szcz761/BD2/README.md

# BD2
Robot klasy minisumo tworzony przez: Szymona Czaje.
Na podstawie robota: Biała-Dama współtworzonego z Markiem Żyśko.
