szcz761/BD2/Biała-Dama Sprawozdanie/tytulowa.tex

\renewcommand{\maketitle}{\begin{titlepage}

\begin{center}
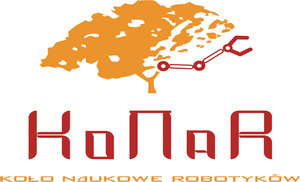
[picture p7: Biała-Dama Sprawozdanie/logo.png]

\vspace*{1cm}
\noindent \rule{\linewidth}{0.4mm}
\LARGE \textsc{Raport z Budowy Robota: \\ BD2} % Tutaj należy umieścić tytuł projektu 
\vspace*{0.5cm}
\rule{\linewidth}{0.4mm}
\vspace*{1cm}
\LARGE
\textsc{Wykonał: Szymon Czaja}  \\% W tym miejscu należy zamieścić 
\textsc{} \\
\large
\textsc{Na bazie projektu Biała Dama stworzonego przez Szymona Czaje i Marka Żyśko } \\ % W tym miejscu należy zamieścić 

\vspace*{2cm}
\textsc{Koło Naukowe Robotyków KoNaR }\\
\textsc{\url{www.konar.pwr.edu.pl}}\\
\textsc{\today}\\
\end{center}
\end{titlepage}
\newpage
}
