szcz761/BD2/Biała-Dama Sprawozdanie/figures/ledy.png

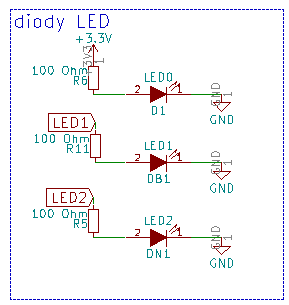
Biała-Dama Sprawozdanie/figures/ledy.png
