szcz761/BD2/Biała-Dama Sprawozdanie/figures/stabilizacja.png

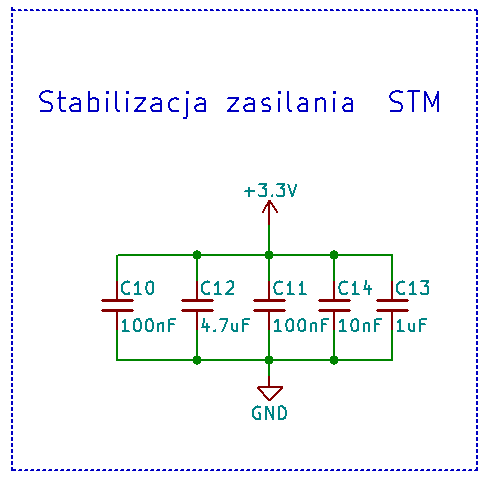
Biała-Dama Sprawozdanie/figures/stabilizacja.png
