szcz761/BD2/(list of files, cad)

Other CAD files:
BDinv.iam
