szcz761/BD2/BD2 - Projekt płytki/BD.kicad_pcb

## KiCad design BD2 - Projekt płytki/BD.kicad_pcb (2018-01-29)

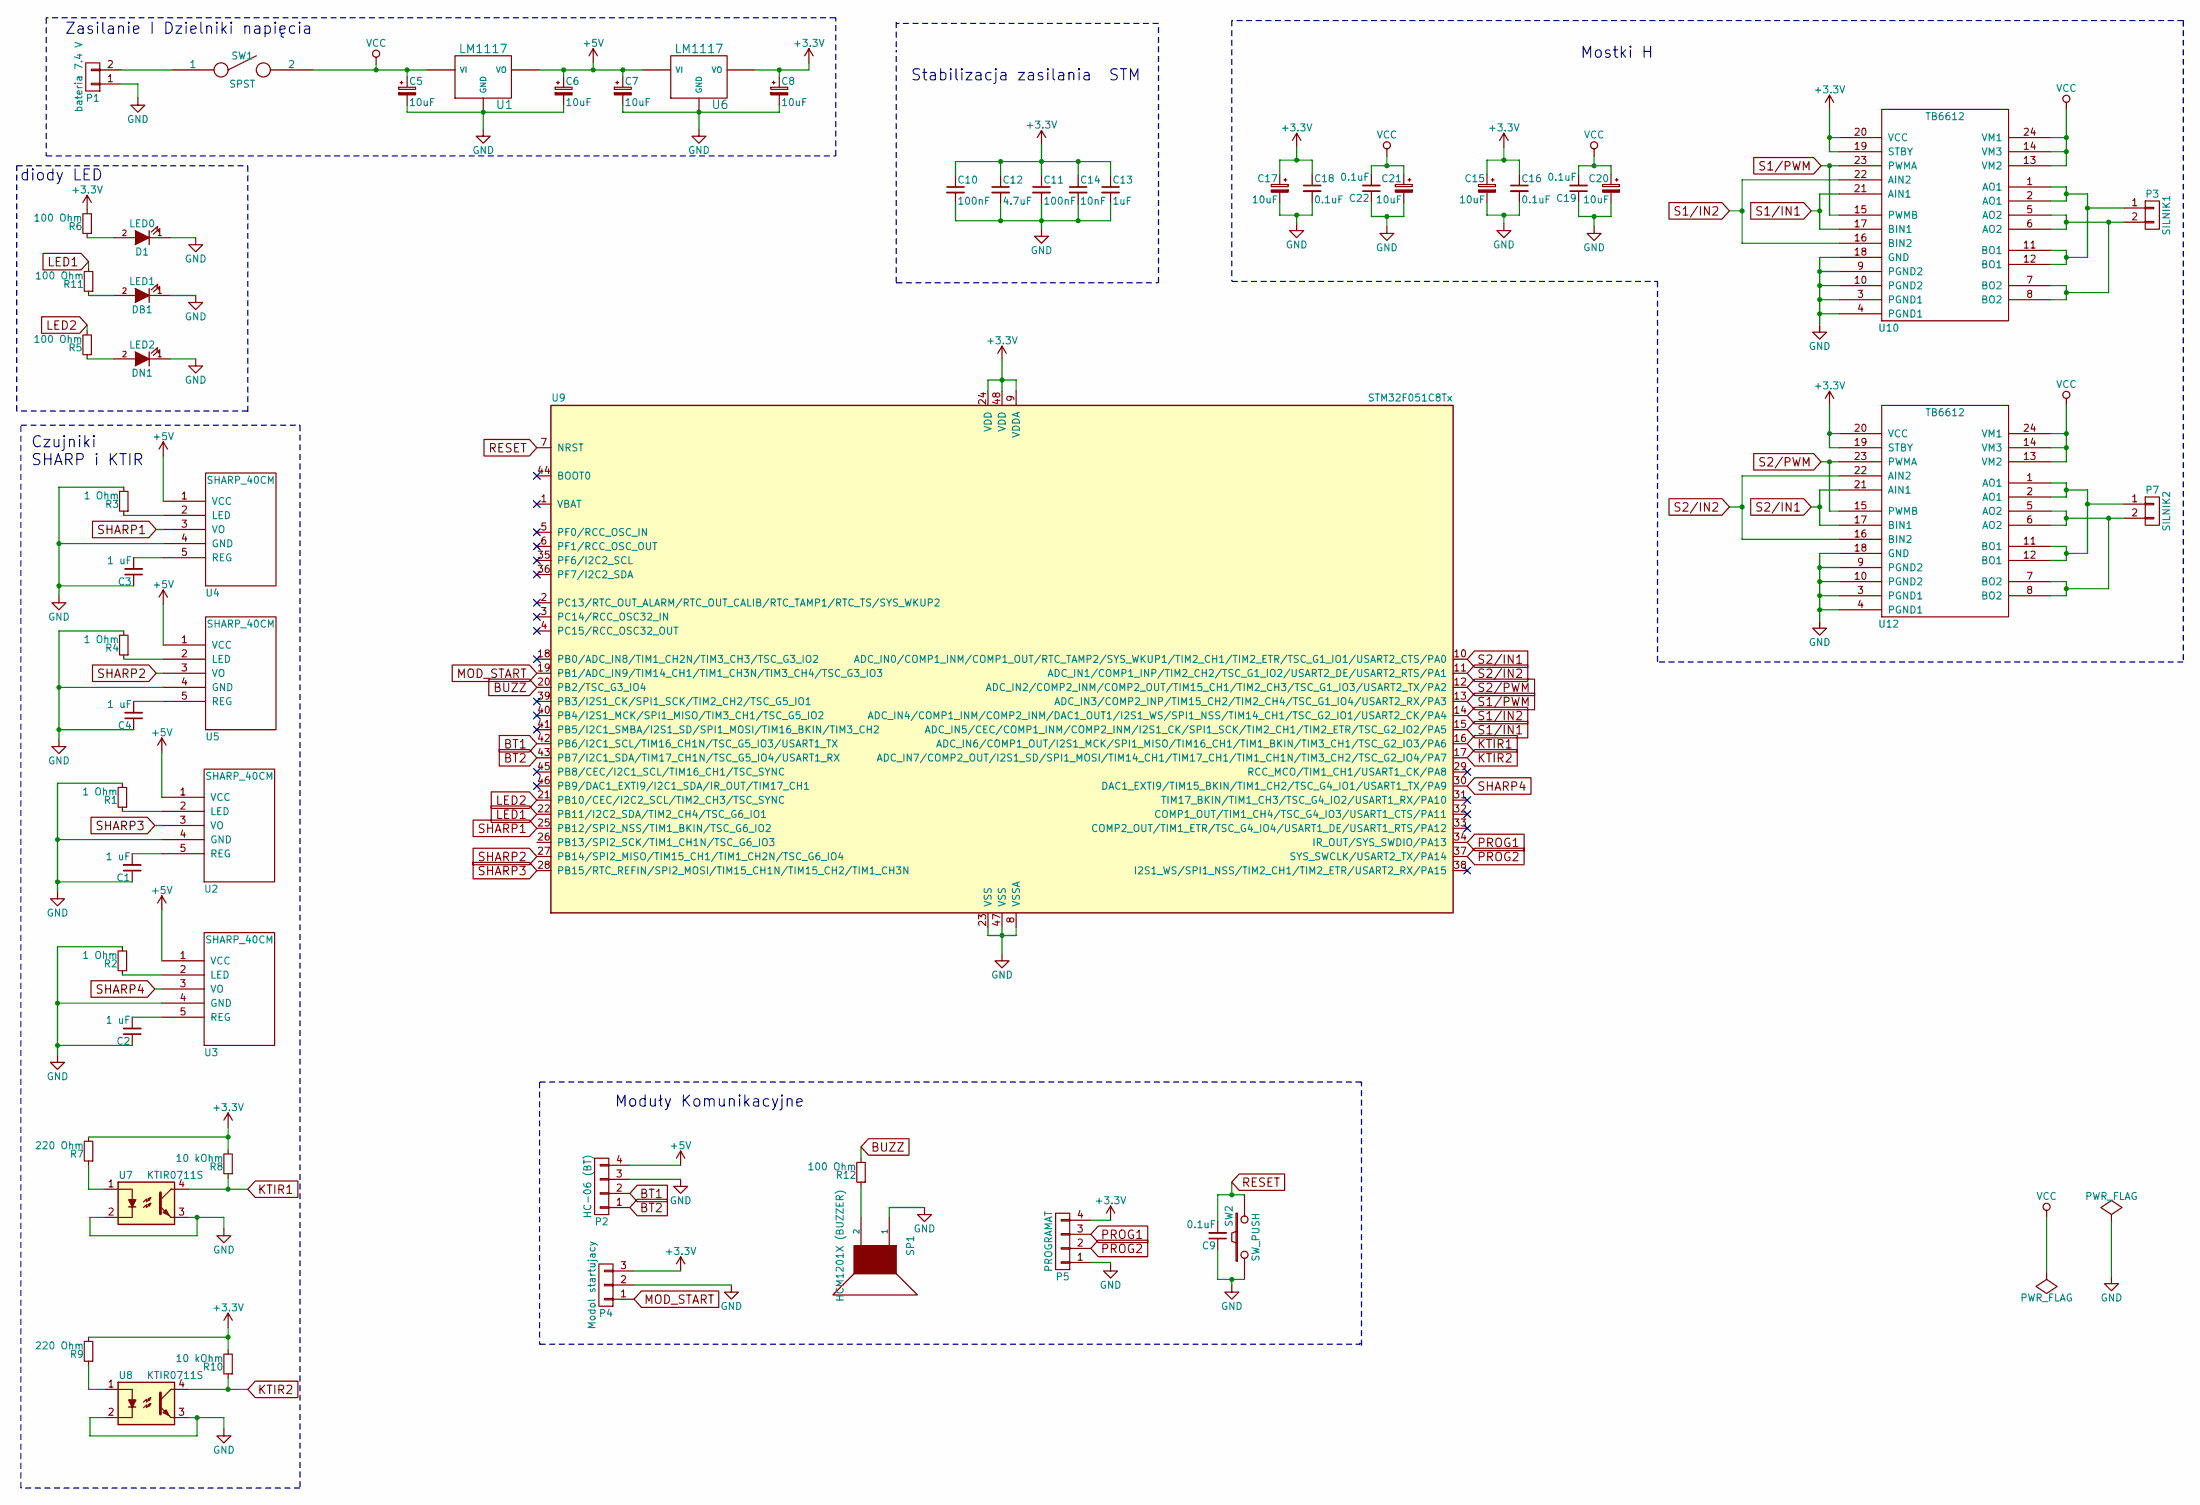
[picture p10: schematic BD.sch]

Parts:
C1, C2, C3, C4: 1 uF; C_0805_HandSoldering
C5, C6, C7, C8, C15, C17, C20, C21: 10uF; Tantalum_Case-A_EIA-3216-18_Hand
C9, C16, C18, C19, C22: 0.1uF; C_0805_HandSoldering
C10, C11: 100nF; C_0805_HandSoldering
C12: 4.7uF; C_0805_HandSoldering
C13: 1uF; C_0805_HandSoldering
C14: 10nF; C_0805_HandSoldering
D1: LED0; LED_0805
DB1: LED1; LED_0805
DN1: LED2; LED_0805
P1: bateria 7.4 V; Socket_Strip_Straight_1x02
P2: HC-06 (BT); Socket_Strip_Straight_1x04
P3: SILNIK1; Socket_Strip_Straight_1x02
P4: Modol startujacy; Socket_Strip_Straight_1x03
P5: PROGRAMAT; Socket_Strip_Straight_1x04
P7: SILNIK2; Socket_Strip_Straight_1x02
R1, R2, R3, R4: 1 Ohm; R_0805_HandSoldering
R5, R6, R11, R12: 100 Ohm; R_0805_HandSoldering
R7, R9: 220 Ohm; R_0805_HandSoldering
R8, R10: 10 kOhm; R_0805_HandSoldering
SP1: HCM1201X (BUZZER); Buzzer_12x9.5RM7.6
SW1: SPST; SW_DIP_x1_Slide
SW2: SW_PUSH; SW_PUSH_6mm
U1, U6: LM1117; LM1117_SOT223
U2, U3, U4, U5: SHARP_40CM; GP2Y0D340K
U7, U8: KTIR0711S
U9: STM32F051C8Tx; STM32F051C8T6
U10, U12: TB6612

Connections:
+3V3: C8.1, C10.1, C11.1, C12.1, C13.1, C14.1, C15.1, C16.1, C17.1, C18.1, P4.3, P5.4, R6.2, R7.2, R8.2, R9.2, R10.2, U6.2 (VO), U9.9 (VDDA), U9.24 (VDD), U9.48 (VDD), U10.19 (STBY), U10.20 (VCC), U12.19 (STBY), U12.20 (VCC)
+5V: C6.1, C7.1, P2.4, U1.2 (VO), U2.1 (VCC), U3.1 (VCC), U4.1 (VCC), U5.1 (VCC), U6.1 (VI)
BT1: P2.2, U9.42 (PB6/I2C1_SCL/TIM16_CH1N/TSC_G5_IO3/USAR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)
BT2: P2.1, U9.43 (PB7/I2C1_SDA/TIM17_CH1N/TSC_G5_IO4/USAR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)
BUZZ: R12.2, U9.20 (PB2/TSC_G3_IO4)
GND: C1.1, C2.1, C3.1, C4.1, C5.2, C6.2, C7.2, C8.2, C9.1, C10.2, C11.2, C12.2, C13.2, C14.2, C15.2, C16.2, C17.2, C18.2, C19.1, C20.2, C21.2, C22.1, D1.1 (K), DB1.1 (K), DN1.1 (K), P1.1, P2.3, P4.2, P5.1, R1.2, R2.2, R3.2, R4.2, SP1.1, SW2.1, U1.3 (GND), U2.4 (GND), U3.4 (GND), U4.4 (GND), U5.4 (GND), U6.3 (GND), U7.2, U7.3, U8.2, U8.3, U9.8 (VSSA), U9.23 (VSS), U9.47 (VSS), U10.3 (PGND1), U10.4 (PGND1), U10.9 (PGND2), U10.10 (PGND2), U10.18 (GND), U12.3 (PGND1), U12.4 (PGND1), U12.9 (PGND2), U12.10 (PGND2), U12.18 (GND)
KTIR1: R8.1, U7.4, U9.16 (ADC_IN6/COMP1_OUT/I2S1_MCK/SPI1_MISO/TI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)
KTIR2: R10.1, U8.4, U9.17 (ADC_IN7/COMP2_OUT/I2S1_SD/SPI1_MOSI/TIM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)
LED1: R11.2, U9.22 (PB11/I2C2_SDA/TIM2_CH4/TSC_G6_IO1)
LED2: R5.2, U9.21 (PB10/CEC/I2C2_SCL/TIM2_CH3/TSC_SYNC)
MOD_START: P4.1, U9.19 (PB1/ADC_IN9/TIM14_CH1/TIM1_CH3N/TIM3_CH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)
unnamed: C1.2, U2.5 (REG)
unnamed: C2.2, U3.5 (REG)
unnamed: C3.2, U4.5 (REG)
unnamed: C4.2, U5.5 (REG)
unnamed: D1.2 (A), R6.1
unnamed: DB1.2 (A), R11.1
unnamed: DN1.2 (A), R5.1
unnamed: P1.2, SW1.1
unnamed: P3.1, U10.1 (AO1), U10.2 (AO1), U10.11 (BO1), U10.12 (BO1)
unnamed: P3.2, U10.5 (AO2), U10.6 (AO2), U10.7 (BO2), U10.8 (BO2)
unnamed: P7.1, U12.1 (AO1), U12.2 (AO1), U12.11 (BO1), U12.12 (BO1)
unnamed: P7.2, U12.5 (AO2), U12.6 (AO2), U12.7 (BO2), U12.8 (BO2)
unnamed: R1.1, U2.2 (LED)
unnamed: R2.1, U3.2 (LED)
unnamed: R3.1, U4.2 (LED)
unnamed: R4.1, U5.2 (LED)
unnamed: R7.1, U7.1
unnamed: R9.1, U8.1
unnamed: R12.1, SP1.2
PROG1: P5.3, U9.34 (IR_OUT/SYS_SWDIO/PA13)
PROG2: P5.2, U9.37 (SYS_SWCLK/USART2_TX/PA14)
RESET: C9.2, SW2.2, U9.7 (NRST)
S1/IN1: U9.15 (ADC_IN5/CEC/COMP1_INM/COMP2_INM/I2S1_CK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), U10.17 (BIN1), U10.21 (AIN1)
S1/IN2: U9.14 (ADC_IN4/COMP1_INM/COMP2_INM/DAC1_OUT1/I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), U10.16 (BIN2), U10.22 (AIN2)
S1/PWM: U9.13 (ADC_IN3/COMP2_INP/TIM15_CH2/TIM2_CH4/TS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), U10.15 (PWMB), U10.23 (PWMA)
S2/IN1: U9.10 (ADC_IN0/COMP1_INM/COMP1_OUT/RTC_TAMP2/S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), U12.17 (BIN1), U12.21 (AIN1)
S2/IN2: U9.11 (ADC_IN1/COMP1_INP/TIM2_CH2/TSC_G1_IO2/U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), U12.16 (BIN2), U12.22 (AIN2)
S2/PWM: U9.12 (ADC_IN2/COMP2_INM/COMP2_OUT/TIM15_CH1/T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), U12.15 (PWMB), U12.23 (PWMA)
SHARP1: U4.3 (VO), U9.25 (PB12/SPI2_NSS/TIM1_BKIN/TSC_G6_IO2)
SHARP2: U5.3 (VO), U9.27 (PB14/SPI2_MISO/TIM15_CH1/TIM1_CH2N/TSC_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)
SHARP3: U2.3 (VO), U9.28 (PB15/RTC_REFIN/SPI2_MOSI/TIM15_CH1N/TIM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)
SHARP4: U3.3 (VO), U9.30 (DAC1_EXTI9/TIM15_BKIN/TIM1_CH2/TSC_G4_I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)
VCC: C5.1, C19.2, C20.1, C21.1, C22.2, SW1.2, U1.1 (VI), U10.13 (VM2), U10.14 (VM3), U10.24 (VM1), U12.13 (VM2), U12.14 (VM3), U12.24 (VM1)

Notes on the sheet:
Zasilanie I Dzielniki napięcia
diody LED
Czujniki SHARP i KTIR
Moduły Komunikacyjne
Mostki H
Stabilizacja zasilania STM

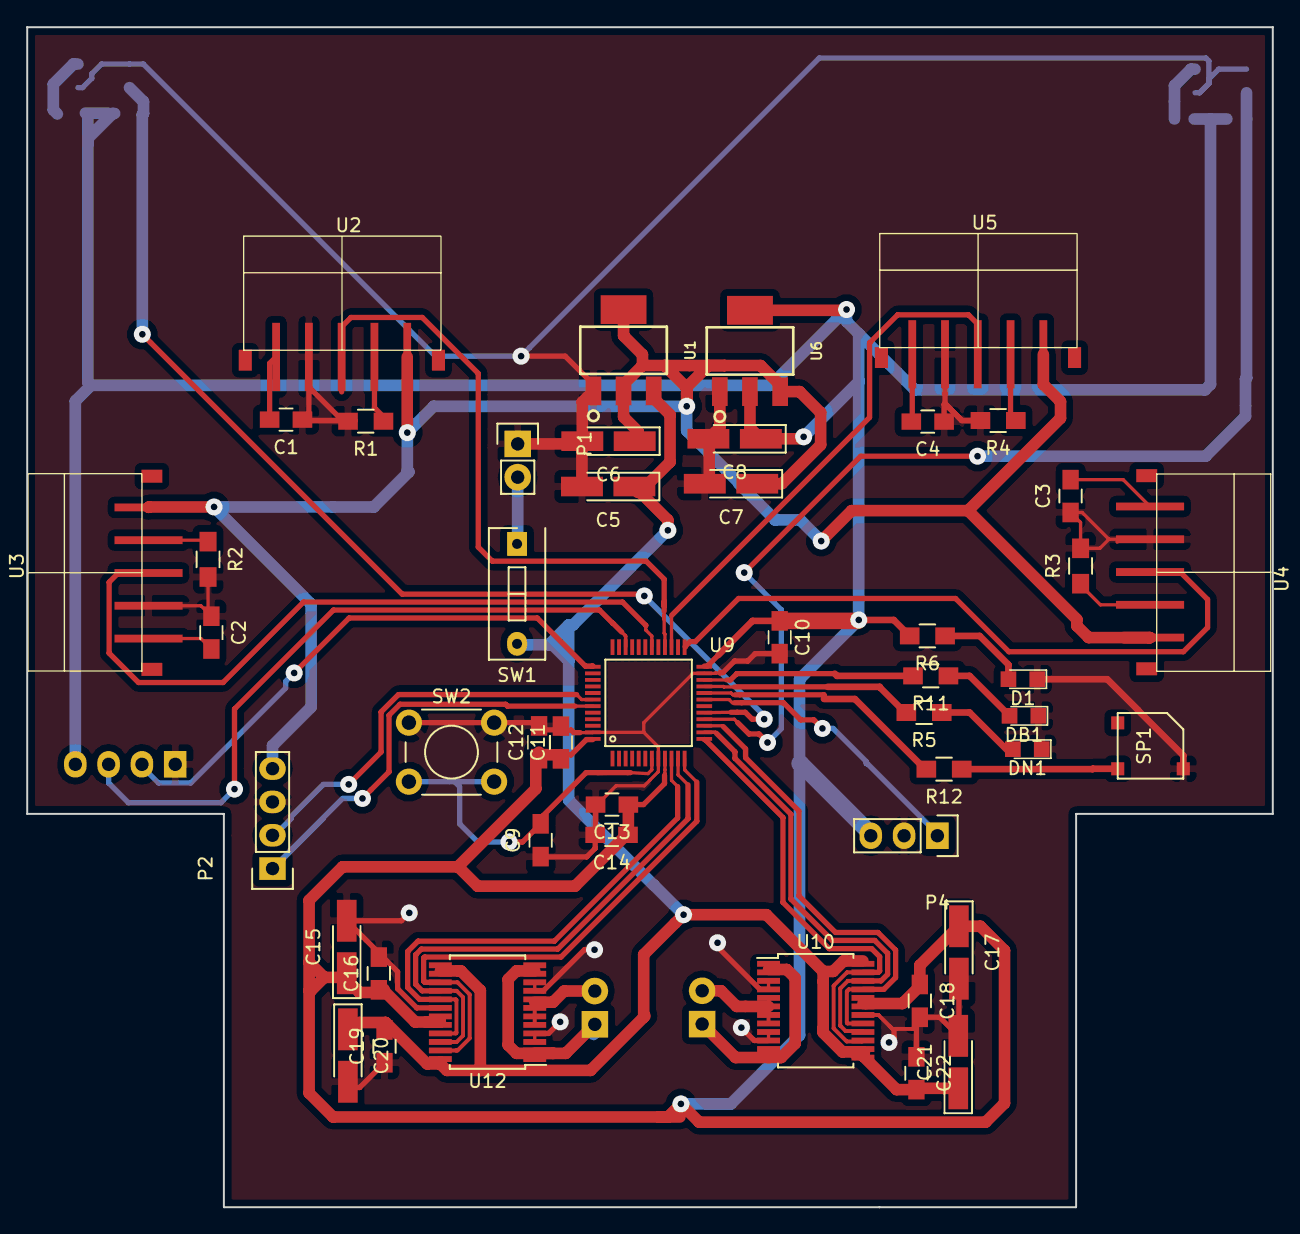
[picture p11: board BD.kicad_pcb from above]

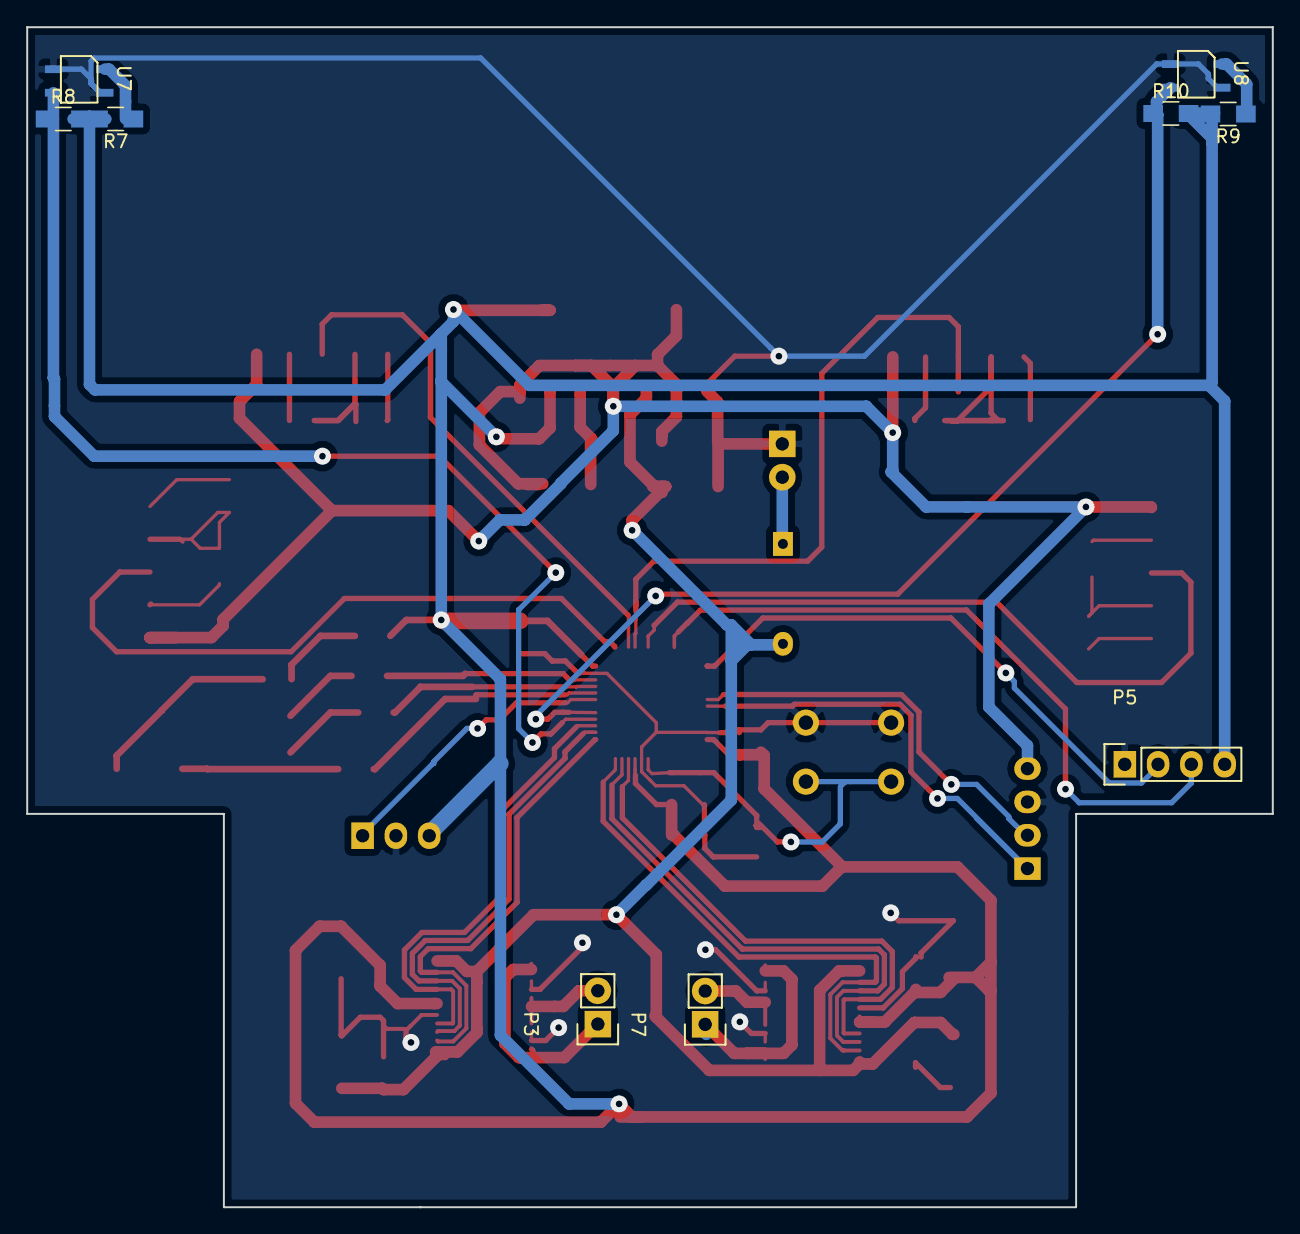
[picture p12: board BD.kicad_pcb from below]

Board: 2 copper layers, 95.0 x 90.0 mm, 57 parts (9 on the bottom side), 44 nets.
