szcz761/BD2/STM/BialaDama2.ioc

Mcu.UserName=STM32F051C8Tx
PA0.GPIO_Label=S2/IN1
PA0.Signal=GPIO_Output
PA1.GPIO_Label=S2/IN2
PA1.Signal=GPIO_Output
PA13.GPIO_Label=PROG1
PA13.Signal=SYS_SWDIO
PA14.GPIO_Label=PROG2
PA14.Signal=SYS_SWCLK
PA2.GPIO_Label=S2/PWM
PA2.Signal=S_TIM2_CH3
PA3.GPIO_Label=S1/PWM
PA3.Signal=S_TIM2_CH4
PA4.GPIO_Label=S1/IN2
PA4.Signal=GPIO_Output
PA5.GPIO_Label=S1/IN1
PA5.Signal=GPIO_Output
PA6.GPIO_Label=KTIR1
PA6.Signal=ADC_IN6
PA7.GPIO_Label=KTIR2
PA7.Signal=ADC_IN7
PA9.GPIO_Label=SHARP4
PA9.Signal=GPIO_Input
PB1.GPIO_Label=MOD_START
PB1.Signal=GPIO_Input
PB10.GPIO_Label=LED2
PB10.Signal=GPIO_Output
PB11.GPIO_Label=LED1
PB11.Signal=GPIO_Output
PB12.GPIO_Label=SHARP1
PB12.Signal=GPIO_Input
PB14.GPIO_Label=SHARP2
PB14.Signal=GPIO_Input
PB15.GPIO_Label=SHARP3
PB15.Signal=GPIO_Input
PB2.GPIO_Label=BUZZ
PB2.Signal=GPIO_Output
PB6.GPIO_Label=BT2
PB6.Signal=USART1_TX
PB7.GPIO_Label=BT1
PB7.Signal=USART1_RX
