szcz761/BD2/(notices)

Notices in the files:
WorkBench/BialaDama2/Src/main.c:
(C) COPYRIGHT STMicroelectronics *****END OF FILE
